Aecasorg/Equine-Foaling-Alarm/docs/UPGRADE-PLAN.md

# Upgrade programme — July 2026

The 2020 build triggers on a tilt switch alone, which can only answer *"is the mare
flat right now?"*. Mares also lie flat in normal REM sleep, so a tilt-only alarm is
structurally stuck between too sensitive (fires on naps) and not sensitive enough
(raise the threshold and miss the real thing). The sleeping position and the labour
position are the same position — the fix is to detect **behaviour** (motion patterns)
rather than **position**.

Three updates are planned. Code for 1 + 2 is already merged into
[`GiiFoalAlarm.ino`](../GiiFoalAlarm.ino); hardware is fitted step by step, sensor first.

## Status at a glance

| # | Update | Code | Hardware | Calibrated | Field-tested |
|---|---|:----:|:---:|:---:|:---:|
| 1 | MPU-6050 motion sensor | ✅ | ✅ 28 Jul 2026 | — self-arms | ☐ |
| 2 | Battery monitoring + heartbeat SMS | ✅ | ✅ 28 Jul 2026 | ✅ 30 Jul 2026 | ☐ |
| 3 | External charging socket | ✅ | ✅ 28 Jul 2026 | — | ☐ |
| 4 | Native UK SIM (roaming sunset) | — (no code) | ✅ 30 Jul 2026 | — | ☐ |

Hardware fitted 28 Jul 2026: GY-521 soldered in (its four unused pins INT/AD0/XCL/XDA
are parked on strips shared with unused MKR digital pins — **treat those digital pins
as reserved in any future code**), SDA/SCL/power run by wire, old tilt switches
desoldered, battery divider wired to A1, external socket wired to the 5V pin, and a
fresh LiPo fitted. External 5 V confirmed to power the board + sensor. Next:
flash, DIVIDER_RATIO check, bench arming + alarm tests, ship.

Legacy tilt-switch firmware (deployed 2022–2026) is archived in
[`legacy/GiiFoalAlarm-tilt-2022.ino`](../legacy/GiiFoalAlarm-tilt-2022.ino).

---

## 1. MPU-6050 motion sensor (major update)

Replace the two parallel ball tilt switches with a GY-521 (MPU-6050) accelerometer +
gyroscope, and replace the single "flat for 30 s" trigger with pattern detection.

**Wiring** (see [wiring-mpu6050-battery.svg](wiring-mpu6050-battery.svg)):

| GY-521 pin | MKR GSM 1400 pin |
|---|---|
| VCC | VCC (**3.3 V pin — not 5V**) |
| GND | GND |
| SCL | D12 (SCL) |
| SDA | D11 (SDA) |
| XDA / XCL / AD0 / INT | not connected (AD0 floating = I²C address 0x68, which the library expects) |

**Space-saving tip:** only the first four pins in the GY-521's row (VCC, GND, SCL,
SDA) are needed — snap the header down to a 4-pin piece, solder just those, and
leave XDA/XCL/AD0/INT pads empty (AD0 unconnected = address 0x68, which the library
expects). Dab of hot glue under the unsupported end. On perma-proto board, holes in
a column strip are connected — so a soldered-in pin "touching" an MKR pin's strip is
wired to it. Unused GY pins sharing strips with unused MKR pins (~2–~5) is
tolerable, but keep AD0 off anything that can sit high, and keep everything off the
D1 strip while the old tilt switches + pull-up are fitted — that strip still swings
3.3 V/GND as the balls roll. Best: desolder the tilt switches and their pull-up
(code-dead since the rewrite) — it frees board space too.

**Alarm tiers** (each sends a distinct SMS):

| Tier | Condition | Meaning |
|---|---|---|
| LABOUR | flat AND gyro-active for 8 s | fast, confident alarm — a sleeping mare is flat but *still* |
| BACKSTOP | **disabled** (`CALM_FLAT_BACKSTOP = 0`) | was "flat 25 min even if calm → check mare"; removed 2 Aug 2026 because mares rest flat routinely and it alerted on normal sleep. Trade-off accepted: no alert for a silent labour or a cast mare lying still. Set the constant (e.g. 3600 s) to re-enable |
| EARLY WARNING | ≥3 lie-down episodes in 20 min (3 s debounce) | stage-1 restlessness starting |

**Mounting hardware:** spring belt clips
([eBay 334736377513](https://www.ebay.co.uk/itm/334736377513), ✅ bought) — the box
clips onto the headcollar and pops off one-handed for charging, replacing the old
duct-tape/trigger-clip arrangement. Fit notes: the box must go back in the **same
position and orientation every time** (the axis calibration assumes it — mark the
spot), and a small keeper strap/lanyard is a cheap backstop since spring clips can
work loose on a horse that rubs or rolls.

**Self-arming detection (no manual calibration, no mode switch):** the device is
shipped to a remote operator, so nothing may require a laptop. The sketch learns
its own "upright" reference every time it is fitted: at power-on, and again after
every unplug from the charger, it enters a *settling* state (alarms off). Once its
gravity direction has held steady for 2 minutes — what naturally happens when it's
clipped on and hanging — it locks the reference and texts **"Foal alarm ARMED"**.
"Lying flat" is then any tilt more than 60° away from that reference. If it hasn't
armed within 30 minutes it texts a nudge to check it's clipped on. Every charge
cycle therefore re-fits the reference automatically.

Prefer the **dangling** arrangement: a hanging box self-plumbs, so grazing, head
position and box spin never move it off its reference. A rigid flat-to-cheekpiece
belt-clip mount also works, but a grazing head-down pose comes within ~10–15° of
the 60° flat threshold, so the margin is slimmer.

**Operator rules to ship with the device:** fit it to a *standing* horse, and
switch it on (or unplug it from the charger) around fitting time rather than hours
before — it locks onto the first steady orientation it sees, so don't let that be
a shelf. Wait for the ARMED text before walking away. **When switching it off,
leave it off for ~30 seconds before switching on again** — the radio coasts on
stored charge for several seconds (watch the LEDs fade), and a quick off–on wakes
it in a wedged state that can't reconnect. Off until dark + a few seconds = clean
start.

**Bench tests before shipping** (Serial Monitor @ 9600 shows
`state / |a| / tilt / stable / motion` once a second; for quick tests drop
`ARM_SECS` to ~15, then restore):
- Hang the box still by its clip → "Foal alarm ARMED" SMS after the settle period.
- Armed + hanging still → no further SMS.
- Lay it flat + shake/rock ~8 s → LABOUR SMS.
- Lay it flat + hold still → silence (nap immunity; the backstop text is disabled).
- Flat ≥3 s / upright / repeat ×3 → EARLY WARNING SMS.
- Plug the charger in → "Charger connected", alarms dormant; unplug → re-arms after
  a fresh settle.
- Text "status" to the SIM from a phone NOT in the alert list → within ~1 min the
  status reply lands ONLY on that phone.

**Main tuning dials:** `MOTION_THRESHOLD` (30 °/s) and `ACTIVE_SECS_LABOUR` (8 s) —
raise if jumpy, lower if deaf. `FLAT_ANGLE_DEG` (60°) for flat-detection margin,
`ARM_SECS` (120 s) for how long settling takes.

## 2. Battery monitoring + daily heartbeat SMS

Battery state becomes visible remotely instead of via the power-LED window.

**Hardware:** two 100 kΩ resistors (1% metal film) as a divider —
battery + (JST side of the on/off switch) → 100 kΩ → **A1** → 100 kΩ → GND.
Same diagram as update 1. Drain ~20 µA, negligible.

**Firmware (already in the sketch):**

| SMS | When |
|-----|---|
| `Foal alarm online. Batt 87% (3.95V). Arming once fitted & settled` | every power-on (doubles as install check) |
| `Foal alarm ARMED. Batt 85%` | orientation held steady 2 min — reference locked, monitoring live |
| `Foal alarm NOT armed yet - check it is clipped on and hanging still` | one nudge if still unarmed 30 min after power-on/unplug |
| `Foal alarm OK (armed). Batt 78% (3.90V)` | daily heartbeat (~24 h) with armed state; a *missing* heartbeat means the unit is dead/flat/out of signal |
| `LOW BATTERY 3.38V - charge foal alarm` | sustained reading < 3.40 V; re-arms after charging past 3.70 V |
| `Charger connected. Batt 42%` | external 5 V detected — posture alarms suppressed while on charge |
| `Battery full - foal alarm ready` | charger present and the BQ24195 reports charge complete |
| `Foal alarm status: armed. Batt 78% (3.90V). Sig 12/31` | reply to any SMS starting with "status" (case-insensitive) — sent **only to the asking number**; inbox is polled every ~30 s, so allow up to a minute; all other inbound texts are discarded (keeps the modem's message store from filling) |

**Calibration:** compare the boot SMS voltage against a multimeter on the battery and
nudge `DIVIDER_RATIO` (2.0 nominal) until they agree. **Done 30 Jul 2026:** off-charger,
same-minute readings were SMS 4.02 V vs meter 4.03 V — 0.25% off, within resistor
tolerance, ratio kept at 2.0. (Note: "Battery full" tops out around ~89% on the SMS
scale by design — the charger terminates at ~4.11 V, not 4.20 V, for cell longevity.)

**Expected battery life:** ~2–4 days per charge (modem dominates; weak signal and
cold nights push it toward the low end). The heartbeat's day-over-day % drop gives
the true figure.

## 3. External charging socket (no more opening the box)

**Part:** 2-pin waterproof panel-mount USB-C female socket (e.g. RUNCCI-YUN,
Amazon B0CRD36F38 / B0CPLS1X29). Power-only — firmware flashing still uses the
internal USB port.

**Why it works without the USB connector** (see
[wiring-charge-port.svg](wiring-charge-port.svg)): on the MKR GSM 1400 schematic the
`5V` header pin is the same net as USB VBUS, behind polyfuse F1; that net feeds the
BQ24195L charger input through Schottky D3. Solder the socket's **+** to the `5V`
pin row and **−** to GND and charging is electrically identical to plugging in USB.
(`VIN` is *not* equivalent — it enters via a FET switch and does not run the charger.)

The board's LEDs (visible through the housing window) become the charge indicator:
green DL3 = charger present, orange DL2 = charging, orange off = full.

**Usage rules:**
1. Meter the socket's two wires for polarity before first connection — reversed
   polarity is unrecoverable.
2. Charge from a **USB-A charger with an A-to-C cable**. The 2-pin socket has no CC
   pull-down resistors, so C-to-C chargers deliver 0 V.
3. On/off switch **ON** while charging, otherwise the board runs but the battery
   can't fill.
4. Never feed the internal USB port and the external socket at the same time.

**Charge rate:** the charger's USB D+/D− detection lines are unpopulated on this
board, so input is capped at ~500 mA regardless of charger — a full 2500 mAh charge
from empty is ~5–6 h.

**Mounting:** ~12–14 mm hole in a *downward-facing* wall, gasket on a flat surface,
cap on in the field. The socket is a dead input while on the horse — no corrosion
or short risk.

**Charging routine** (with updates 1–3 all fitted): unclip the box from the
headcollar → plug into the dedicated USB-A charger in the tack room → clip back on.
The belt clip removes the tape faff, the socket removes the unscrew-the-lid step;
charging itself always happens off the horse.

**Firmware charger-awareness:** because the box is powered while charging (switch
must be ON) and lies flat on a shelf for hours, the sketch reads the BQ24195's
status register (read-only, shared I²C bus) each second. While external 5 V is
present the posture alarms are suppressed and their state zeroed — otherwise the
25-min backstop would text "CHECK MARE" during every charge. Plugging in sends
`Charger connected. Batt XX%` (proof the socket made contact), and charge
completion sends `Battery full - foal alarm ready`.

---

## 4. SIM replacement (diagnosed 29 Jul 2026)

The original Things Mobile (Italian roaming) SIM can no longer connect anywhere in
the UK on this hardware, through no fault of the device:

- The SARA-U201 modem is **2G/3G only**.
- All four UK operators completed their **3G switch-offs** by 2025.
- **O2 — the last UK network accepting inbound 2G roamers — withdrew that access
  from 1 Oct 2025** (Ofcom, "advice for IoT and third-party device suppliers").
  Foreign roaming SIMs on 2G-only devices now get rejected by every UK network.
- Confirmed by the AT diagnostic: modem healthy (IMEI OK), SIM healthy
  (`+CPIN: READY`), network heard and attach attempted, ends `+CREG: 0,3`
  = registration **denied** (policy, not signal).

**Fix:** a native UK PAYG SIM on the EE, O2 or Vodafone families (native/MVNO SIMs
are unaffected; their 2G runs until ~2029–2030).

**Decision: Lebara (Vodafone MVNO).** Already used for the farm's LTE surveillance
camera with good reception, so Vodafone has proven presence on site; Lebara SIMs
include Vodafone 2G access. Note the camera proves the 4G layer — verify the 2G
"calls & texts" layer for the farm postcode on Lebara's coverage checker before
relying on it. Lebara's ~90-day inactivity policy is covered by the daily
heartbeat SMS. Steps:

- [ ] Check **2G coverage at the farm** per network (signalchecker.co.uk) and pick
      accordingly — rural 900 MHz (O2/Vodafone) often carries further than
      1800 MHz (EE).
- [x] Fit SIM (slot on the underside of the MKR); Lebara ships PIN-free, so
      `SECRET_PINNUMBER` is now `""`.
- [x] Re-run the GSM diagnostic — **passed 30 Jul 2026**: registered on
      "Lebara" (2G, `+CREG: 0,1`). Bench signal CSQ 5/31 (weak indoors, as
      expected at that spot); status SMSes now report signal so the farm
      fitting gives the number that matters.
- [ ] Note: the daily heartbeat SMS doubles as the PAYG keep-alive — most PAYG
      SIMs deactivate after ~6 months without chargeable activity.

Long-term note: UK 2G sunsets ~2029–2030. If the alarm must outlive that, the
successor path is the pin-compatible Arduino MKR NB 1500 (LTE-M) — the MKRNB
library mirrors MKRGSM almost 1:1.

**Tool — reading SMS sent TO the alarm's SIM:** flash
[`tools/SmsInbox/SmsInbox.ino`](../tools/SmsInbox/SmsInbox.ino) (copy your
`arduino_secrets.h` into its folder) and open the Serial Monitor — every
incoming SMS is printed. Needed for one-time verification codes (Lebara app
registration), balance texts, etc. Re-flash the main sketch afterwards.

## Battery-only GSM attach failure (30 Jul 2026) — ROOT CAUSE FOUND, fix pending

Symptom: on battery only, no 4-blink (GSM `begin()` never succeeds), no SMS; plug
the charger in at the same spot and it registers and texts fine. Same location →
not signal: GSM attach draws ~2 A transmit bursts (max power at Sig 10–12), so
this was power delivery.

**Root cause (confirmed by test): the on/off switch's own contacts.** Jumpering
across the switch terminals — leaving all wires/crimps/connectors in circuit —
restored battery-only attach immediately. Aged, oxidised contacts (never
self-cleaning at ~50 mA idle) drop too much voltage during the 2 A bursts. The
switch ran the old battery for years on shrinking margin; the rebuild moved the
operating point just enough to expose it (hence the intermittent successes
earlier the same day).

**Update 31 Jul 2026 — battery shorted during the rebuild.** Red and black battery
leads got soldered to the same strip: dead short across the cell. Cell now rests at
2.87 V (below the 3.0 V over-discharge floor), "charges" suspiciously fast but won't
run the board — classic short-damaged cell (internal resistance up, capacity gone).
Board itself unharmed (runs on charger). **The cell is compromised and will be
replaced, not rehabilitated** — shorted + over-discharged LiPos are a charge-time
fire risk, unacceptable for an unattended stable device. Do not charge it
unattended; check for swelling/heat/smell and recycle it properly.

**Battery-path rebuild (one work package):**
- [x] Shorting joint removed; harness rebuilt.
- [x] Replacement pack fitted: 724957 (2.5 A listing), its JST direct into the
      MKR socket.
- [x] Inline fuse — **waived** (no holder fits the enclosure; the pack's PCM
      covers hard shorts; radial PTC polyfuse noted as zero-space retrofit).
- [x] 6 A SPST mini toggle spliced into the battery + line via soldered
      perfboard pads; old intermediate connector eliminated.
- [x] Re-verify battery-only attach — **passed 1 Aug 2026 with the case OPEN**
      (4 blinks + SMS on battery). Power path closed. Lid-on failure is a
      separate RF issue (next section).

## Lid-on attach failure — RESOLVED 2 Aug 2026

**Root cause: the thick red switch wires lay across the antenna coax / u.FL
zone; lid compression pressed them onto the feed line.** Rerouted to the far
side of the box → attaches with the lid on. Rule going forward: the coax and
u.FL keep an exclusion zone — no wiring crosses them — and the red pair gets
anchored (hot glue / adhesive tie) so vibration on the horse can't migrate it
back. Final proof: 3× battery-only boots with the lid screwed down + Sig
comparison lid-on vs lid-off (small delta = healthy baseline).

<details><summary>Original diagnosis notes (kept for reference)</summary>

## Lid-on attach failure (open, 1 Aug 2026) — RF path, not power

With the rebuild done, battery-only attach works case-open but fails with the
lid fitted → the lid only touches the RF path. The antenna is external; its coax
enters the box. Suspects in order:

1. Coax pinched at the lid seam (crushed coax ≈ disconnected antenna — look for
   a bite mark on the cable at the case joint).
2. Lid/foam pressure popping the u.FL off the board (open the box immediately
   after a lid-on failure and inspect before touching anything).
3. Foam crushing the coax flat against a board edge.
4. Plain signal margin at the known-weak bench spot (lid costs a couple of dB).

Tests (the boot SMS `Sig n/31` is the instrument):
- [ ] Lid resting vs screwed tight: attaches resting but not screwed =
      mechanical compression.
- [ ] Lid fully on, outdoors/at a window: attaches = box healthy, the shelf is a
      dead spot; the farm fitting (ARMED text signal) is the real verdict.
- [ ] Boot-SMS signal lid-off vs lid-on, same spot: small drop = lid innocent;
      collapse = the closure is wrecking the antenna path.

Fix if it's the seam pinch: a dedicated cable exit (notch or grommet + sealant)
placed so the lid never bears on the coax, with a slack loop inside so lid
pressure can't transfer to the u.FL.

**Findings 1 Aug (photos):** antenna identified — Molex "Cellular 6 Band" 105261
flex, adhered to the OUTSIDE of the long wall. Flex antennas need a
conductor-free zone behind the element, and the lid compresses the interior
stack (black foam block + battery pouch) against the inside of that exact wall.
The rerouted battery wires also now cross over the u.FL zone, giving lid
pressure a path onto the coax head. Refined tests:
- [ ] Meter the black foam (probes ~2 cm apart): any reading = conductive ESD
      foam = an RF absorber pressed on the antenna's back → replace with plain
      non-conductive foam.
- [ ] Lid on with the black foam removed → attaches = culprit confirmed.
- [ ] Open immediately after a lid-on failure: is the u.FL still seated flush?
- [ ] Ensure the battery pouch (metal slab) doesn't press flat against the
      antenna wall under compression; pad with non-conductive foam.
- [ ] Dress wires so nothing crosses the u.FL head; optional rigid bridge over
      it as armour.

</details>

## Before shipping — final checklist

- [ ] **Set the ship recipients in `arduino_secrets.h`**: `SECRET_PHONE_NUMBER`
      = mum (testing currently uses Henrik's number), `SECRET_PHONE_NUMBER_2`
      = Henrik, for remote monitoring ("" disables a slot). Re-flash and
      confirm the boot SMS arrives on both phones. Two recipients = double
      the SMS count on the Lebara tariff.
- [ ] Restore any thresholds relaxed for bench testing (`ARM_SECS` 120;
      `CALM_FLAT_BACKSTOP` stays 0 = backstop disabled by owner decision).
- [ ] Full bench pass: ARMED SMS, labour, backstop, restless, charger
      connect/full/re-arm.
- [ ] New ≥3 A power switch fitted; battery-only GSM attach re-verified
      (several boots + an alarm SMS on battery).
- [ ] Charge to 100 % (orange LED off, `Battery full` SMS).
- [ ] Pack the dedicated USB-A charger + A-to-C cable with the device, plus the
      one-page operator note (fit to a standing horse, wait for the ARMED text,
      charge daily, heartbeat = it's alive).

## Parts list (all three updates)

| Part | Spec | Qty | ~Cost |
|---|---|-----|---|
| MPU-6050 module | GY-521 breakout | 2 (one spare) | £2–3 ea |
| Resistors | 100 kΩ 1% metal film | 2 | pennies |
| USB-C panel socket | 2-pin waterproof, screw-in (RUNCCI-YUN) | pack | ~£8–10 |
| Hook-up wire | thin solid-core | — | ~£2 |
| On/off switch | ✅ bought: SPST mini toggle, 6 A/125 VAC, pre-wired 0.5 mm² leads, 6 mm bushing. Solder (never crimp) where its leads join the harness; add an M6 rubber toggle boot for weather sealing | 1 | ~£2–3 |
| LiPo battery | Existing pack is a 785060 (7.8×50×60). Two candidates, decided by **measured clearance above the battery bay** (a LiPo must never be compressed, and packs swell with age): **≥12 mm free height → 105151** (10×51×53, 3000 mAh, 1.5 A std / 3 A max — electrically the best); **tighter → 724957** (7.2×49×57–59, 2500 mAh; buy the listing that specs 1.25 A std / 2.5 A max — seller tables vary). 375678 rejected: 80 mm too long. **Meter the JST plug polarity before connecting — aftermarket packs often ship reversed and a swapped plug kills the board** | 1 | ~£10 |
| Inline fuse | **Waived** (no holder fits the enclosure; the pack's own PCM covers hard shorts). Zero-space retrofit option if ever wanted: radial PTC polyfuse, hold ≥3 A (RUEF300-class), soldered inline in the + lead under heat-shrink | — | — |
| On/off switch | ≥3 A rated, sealed/rubber boot preferred | 1 | ~£2–3 |
| Belt clips | spring clip, box-to-headcollar quick release ([eBay 334736377513](https://www.ebay.co.uk/itm/334736377513)) | — | ✅ bought |

## Next season (2027) improvements

Field experience 2026: the antenna coax / u.FL zone remains the device's weak
point under shipping + horse vibration ("interference" recurred at the farm).

**Field report, Aug 2026:** armed on the horse at the farm (Sig 14/31 — farm
coverage confirmed good), then went silent; found next day pulled off the
headcollar (herd mate suspected) after a night on the ground — **and found
switched OFF**: the pull-off likely flipped the toggle, so the overnight
silence's primary cause was power loss, with the lid-on coax issue as a second
fault to clear. Still worked lid-open in the garden (Sig 18/31) but not lid-on
→ the known coax/u.FL mechanical fault, re-triggered by the pull-off/impact
(wires were never anchored). Consequences: (a) the keeper strap through the
belt clip is now REQUIRED, not suggested; (b) the missing-heartbeat dead-man
signal worked — that's what prompted the check; (c) the switch needs
protection (see below).

- **Fall-off detection** (new, field-driven): re-purpose the disabled backstop
  tier — a fallen-off box reads as "flat + motionless for hours", which no
  napping mare sustains. Threshold 60–90 min, message
  "Device may have come off the horse - check it" (distinct from the old
  CHECK MARE text). One constant + one string.
- **Switch protection** (field-driven — the box was found switched off after
  the pull-off, and fall-off detection only works if the fall leaves the device
  powered): rubber boot (weather + stiffer action) plus a toggle guard or
  recessed bezel so nothing sweeping past can flip the lever; or relocate the
  switch to the horse-side face — unreachable to herd mates by geometry, still
  accessible at fitting (switching always happens off the horse; could share
  the drilling session with the SMA bulkhead). **Interim field measure: a flap
  of electrical tape over the switch after fitting.**

- **Antenna robustness package** (the structural fix): u.FL→SMA bulkhead pigtail
  through the box wall + rigid external stub antenna. Seat the u.FL once and
  glue-stake it; bulkhead is strain-relieved and sealed. Interim measures that
  should happen at the next box-opening regardless: anchor the red DC pair to
  the far wall, glue-stake the u.FL + coax, twist the DC pair (kills its loop
  area). NOT foil wrap — coax is already shielded; floating foil near the
  element/feed detunes it further.
- **`status` reply gains tilt telemetry**: when armed, append the live angle
  from reference, e.g. `Tilt 12deg (flat >60)`; while arming, append settling
  progress, e.g. `settling 45/120s`. Makes remote diagnosis of arming/flat
  detection possible.
- **Remote re-arm command**: text `rearm` → device disarms and starts a fresh
  settling cycle (same path as unplugging the charger), confirms with
  "Re-arming - will text ARMED when settled". Restrict this command to the two
  alert-list numbers (unlike `status`, it changes device state).

## Parked ideas (not scheduled)

- Charging-status SMS ("plugged in" / "battery full") via the `Arduino_PMIC` library.
- Rigid GoPro-style or Fidlock cradle — fallback if the belt clips (bought, see
  update 1 mounting) prove insecure or don't hold a repeatable orientation.
- Heartbeat at a fixed clock time (RTCZero + network time) instead of ~24 h rolling.
- MCU sleep + MPU motion-interrupt wake for multi-week battery life.
- Second complete unit as a hot spare / swap-to-charge.
- Vulva magnet + reed switch (vet-fitted, Foalert-style) as a near-certain stage-2
  trigger complementing the behavioural early warning.
