Aecasorg/Equine-Foaling-Alarm/(commit log)

2026-07-26 Add 2026 upgrade programme: MPU-6050 sensing, battery telemetry, charge port
    Three tracked updates (status + wiring diagrams in docs/UPGRADE-PLAN.md):
    1. MPU-6050 (GY-521) replaces the parallel tilt switches. Detects labour
    behaviour instead of position alone: flat+active labour alarm, 25 min
    long-flat backstop, restlessness early warning. Supports the current
    hanging clip mount (hang-axis slack detection) and a future fixed
    cheekpiece mount via HANGING_MOUNT.
    2. Battery telemetry: 2x100k divider on A1, boot/daily-heartbeat SMS with
    battery %, sustained low-battery warning.
    3. External waterproof USB-C charge socket wired to the 5V pin (same net
    as USB VBUS -> F1 -> D3 ->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
    [GiiFoalAlarm-tilt-2022.ino, GiiFoalAlarm.ino]
2026-07-26 Add belt-clip mounting to the upgrade plan
    Spring belt clips bought (eBay 334736377513) for one-handed box-on/box-off
    mounting to the headcollar. Documented the HANGING_MOUNT decision at fitting
    time (flat against the cheekpiece -> false, dangling -> true), repeatable-
    position + keeper-strap notes, and demoted the cradle idea to a fallback.
2026-07-26 Clarify charging routine: always off the horse
    Unclip -> charge in the tack room -> clip back on. The belt clip and the
    external socket each remove a step of faff; neither enables on-horse charging.
2026-07-26 Add GY-521 soldering guidance for the cramped perfboard
    Solder only the 4 contiguous used pins (VCC/GND/SCL/SDA); AD0 must never
    sit high (address flips to 0x69), and the D1 strip stays live via the old
    tilt switches + pull-up until they are desoldered.
2026-07-28 Mark updates 1-3 hardware fitted; make LED blinks reliable on cold boot
    pinMode(LED_BUILTIN, OUTPUT) was never called (since 2020) - the LED only
    worked when the bootloader happened to leave the pin configured. Matters now
    that the LEDs are the through-window charge indicator.
    Status: GY-521 in (unused pins parked on unused MKR strips - those digital
    pins are now reserved), tilt switches removed, divider on A1, external socket
    on the 5V pin, fresh LiPo. External 5V confirmed powering board + sensor.
2026-07-28 Suppress posture alarms while on the charger
    The external socket means the box now runs while charging - lying flat on
    a shelf for 5-6 h, which would fire the 25-min CHECK MARE backstop every
    charge (and a full alarm if the box gets knocked). The sketch now reads the
    BQ24195 system-status register each second (read-only, shared I2C bus):
    while external 5V is present the posture alarm state is held at zero, and
    the unit texts "Charger connected" on plug-in and "Battery full" at
    charge termination.
2026-07-28 Replace manual calibration with self-arming orientation learning
    The device ships to a remote operator, so nothing may require Serial or a
    laptop. Instead of a hand-picked axis + HANGING_MOUNT switch, the sketch now
    captures the full gravity vector: on power-on (and after every charger
    unplug) it settles, locks a reference once the orientation has held steady
    for 2 minutes, and texts ARMED. Flat = tilting >60 degrees from that
    reference - works for the dangling mount (self-plumbing, preferred) and
    degrades gracefully on a rigid mount. Adds a 30-min "not armed yet" nudge
    and an armed/not-armed flag in the daily heartbeat.
    [GiiFoalAlarm.ino]
2026-07-28 Add pre-ship checklist (incl. restoring the real alert number)
    Testing runs with Henrik's own number in arduino_secrets.h - the checklist
    makes swapping back before shipping un-forgettable, plus threshold restore,
    full bench pass, 100% charge, and what to pack.
2026-07-28 Make GSM connect retries visible (LED flash + serial line per attempt)
    The connect loop was silent while failing, indistinguishable from a dead
    board - discovered while diagnosing a no-connect after the hardware refit.
    [GiiFoalAlarm.ino]
2026-07-29 Add update 4: replace roaming SIM (UK 2G inbound-roaming sunset)
    Diagnostic verdict: modem + SIM healthy, antenna fixed, but +CREG: 0,3 -
    registration denied by policy. UK 3G is fully off and O2 (last network
    accepting inbound 2G roamers) withdrew access from 1 Oct 2025, so the
    Things Mobile roaming SIM can never register on this 2G/3G modem. Fix is
    a native UK PAYG SIM (EE/O2/Vodafone family); farm coverage check first.
2026-07-29 Record SIM decision: Lebara (Vodafone MVNO)
    Vodafone presence at the farm is proven by the existing LTE camera; Lebara
    includes Vodafone 2G. Remaining check: the 2G calls-and-texts layer at the
    farm postcode (camera only proves 4G). Heartbeat SMS covers the 90-day
    inactivity rule.
2026-07-30 Add tools/SmsInbox: read SMS sent to the alarm's SIM over Serial
    Needed for one-time verification codes (e.g. registering the Lebara SIM
    in the Lebara app) without moving the SIM to a phone. Prints sender +
    body for every incoming SMS, then deletes it from modem storage.
2026-07-30 Detect charging with the switch off (battery out of circuit)
    The divider taps the JST side of the on/off switch, so ~0V on A1 while the
    board runs means the battery is switched out - not a flat cell. Charger
    connect now texts "no battery detected (switch OFF?) - NOT charging"
    instead of a misleading LOW BATTERY 0.03V, and the low-battery warning and
    "battery full" are suppressed in that state. Found during bench testing on
    USB with the switch off.
2026-07-30 Battery divider calibration verified: SMS 4.02V vs meter 4.03V
    Same-minute off-charger comparison; 0.25% agreement is within resistor
    tolerance, DIVIDER_RATIO stays 2.0. Also documented why "full" reads ~89%
    (BQ24195 terminates at ~4.11V by design).
2026-07-30 Log ship-blocker: GSM attach fails on battery, works on charger
    Same-location symptom rules out RF; GSM attach TX bursts (~2A at low
    signal) point at power delivery. Old battery ran years through the same
    switch; suspects are the new cell's protection PCB tripping or a disturbed
    crimp/switch contact. Test ladder documented (LED read, contact re-seat,
    switch bypass, cell-tab droop measurement).
2026-07-30 Battery-attach root cause confirmed: worn on/off switch contacts
    Jumper across the switch terminals (all wiring/crimps still in circuit)
    restored battery-only GSM attach immediately. Oxidised contacts drop too
    much voltage during 2A attach bursts. Fix: >=3A sealed switch, soldered
    lugs; added to parts list and pre-ship checklist. Bench testing continues
    jumpered.
2026-07-30 Support two SMS recipients
    sendSMS() now iterates a recipient list (sequential sends, seconds apart);
    an empty slot is skipped. SECRET_PHONE_NUMBER_2 added to the secrets
    template. Ship config: mum primary, Henrik second for remote monitoring.
    [GiiFoalAlarm.ino]
2026-08-01 Log battery short: cell compromised, replace as part of battery-path rebuild
    Red+black soldered to the same strip = dead short; cell rests at 2.87V,
    fast-full/no-runtime signature of short damage. Replacing (not recharging)
    - shorted + over-discharged LiPo is a charge-time fire risk for an
    unattended stable device. Rebuild package: new >=3A-protected cell, inline
    ~3A fuse in the + lead, >=3A switch, harness inspection, battery-only
    re-verification. Parts list updated.
2026-08-01 Relax battery spec to >=1C discharge; add JST polarity warning
    2.5A-max protected packs are fine - GSM TX bursts are sub-ms pulses that
    bulk caps + protection trip delays absorb. The real hazard with aftermarket
    pouches is reversed JST polarity, which kills the board on connection.
2026-08-01 Battery spec: 0.5C packs workable, 1C preferred; check pack thickness
    Candidate 724957 (2500mAh, PCM, JST-PHR-02, max 1.25A) is acceptable -
    sustained TX averages ~0.5A and bursts are sub-ms pulses. Fit note added:
    the chunkier packs differ in thickness, not just footprint.
2026-08-01 Battery decision: 724957 replaces the 785060 (375678 too long)
    Existing pack is a 785060 (7.8x50x60); the 724957 candidate is smaller on
    every axis so it drops into the same bay. Polarity check reminder stands.
2026-08-01 Battery choice becomes a clearance measurement: 105151 vs 724957
    105151 (10mm thick, 3000mAh, 3A max) is electrically best but 2.2mm
    thicker than the incumbent 785060; LiPos must not be compressed and swell
    with age, so >=12mm measured free height gates it. Otherwise the 724957.
2026-08-02 Record switch purchase: 6A SPST mini toggle, pre-wired leads
    Well over the 3A bar; solder-only joins into the harness, M6 rubber boot
    suggested for weather sealing.
2026-08-02 Waive the inline fuse: no holder fits; pack PCM covers hard shorts
    Radial PTC polyfuse (hold >=3A) noted as the zero-space retrofit if ever
    wanted.
2026-08-03 Power path closed (battery attach passed case-open); open lid-on RF issue
    Rebuild complete: new pack + 6A toggle, soldered path, fuse waived. Attach
    now works on battery with the case open - the remaining failure only
    appears with the lid fitted, which can only touch the RF path. Suspects:
    coax pinched at the lid seam, u.FL popped by lid/foam pressure, foam
    crush, or bench signal margin. Sig-in-SMS comparison is the instrument.
2026-08-03 Lid-on RF issue: antenna is a Molex 105261 flex on the outside wall
    The lid compresses the interior stack (black foam + battery pouch) against
    the inside of the antenna-bearing wall; rerouted wires also cross the u.FL
    zone. Refined test list: meter the black foam for conductivity (ESD foam =
    RF absorber), lid-on-without-foam, u.FL inspection, battery clearance,
    wire dressing.
2026-08-04 Lid-on RF issue resolved: switch wires lay on the antenna coax
    Rerouted the thick red pair to the far side; coax/u.FL now keep an
    exclusion zone. Remaining hardening: anchor the wires, 3x lid-screwed
    battery-only boots, Sig lid-on/off baseline. Old diagnosis notes folded
    into a details block.
2026-08-04 Add SMS "status" query: reply to the asking number only
    Text "status" (case-insensitive) to the SIM -> status report (state,
    battery, signal) sent only to the sender, not the alert list. Inbox
    polled every 30 s to preserve modem power-save; all other inbound texts
    are discarded so the message store can't fill over a season. Added to
    the SMS table and bench test list.
2026-08-04 Fix status reply: build the report before beginSMS
    signalStr() sends AT+CSQ to the modem; calling it after beginSMS (modem in
    text-entry mode) typed the command into the SMS body and returned no
    reading ("AT+CSQ ... Sig ?/31" - caught in field testing). The report is
    now fully built before the send starts. Boot/heartbeat texts were already
    safe (strings built before sendSMS).
    [GiiFoalAlarm.ino]
2026-08-04 Operator rule: leave the switch off ~30s before switching back on
    Bulk caps + modem rails coast for several seconds after switch-off; a
    quick off-on wakes the modem half-brown and it can fail to reattach even
    through the retry loop. Cold-boot after full drain works every time.
    Also explains the earlier "standing up = no signal" scare (confounded by
    rapid power cycling during those tests).
2026-08-04 Add the one-page operator note to ship with the device
    Fitting ritual (standing horse, wait for ARMED), text meanings incl. the
    missing-heartbeat rule and the status query, charging routine (USB-A brick
    only, LED meanings, ~2-day cadence), and the rules of thumb (30s off-time,
    hang freely, ~90% = full).
2026-08-04 Operator note: charge from any USB-A brick via the supplied cable
    Device draws max 0.5A@5V so any USB-A charger works; the A-to-C cable
    physically enforces the right port type, so "only use this cable" is the
    whole rule. No brick shipped - mum's kitchen charger does the job.
2026-08-05 Operator note: the supplied cable is black
2026-08-08 Plan next-season improvements: antenna robustness, tilt in status, remote rearm
    Field 2026 verdict: the u.FL/coax zone is the recurring weak point. 2027
    package: SMA bulkhead + stub antenna (structural fix), plus interim
    glue-staking/anchoring/twisted-pair at next box-opening; foil wrap
    explicitly rejected (coax already shielded, floating foil detunes).
    Features: status reply gains tilt/settling telemetry; "rearm" command
    restricted to alert-list numbers.
2026-08-08 Field report: farm signal good (14-18/31); pull-off re-triggered coax fault
    Armed on-horse at Sig 14/31, went silent, found pulled off after a night on
    the ground; works lid-open (Sig 18/31), dead lid-on = the known u.FL/coax
    mechanical fault. Keeper strap promoted to required. New next-season item:
    fall-off detection by re-purposing the disabled backstop (flat+still 60-90
    min -> "device may have come off the horse").
2026-08-08 Field addendum: box found switched OFF; add switch protection to 2027 plan
    The pull-off likely flipped the toggle, making power loss the primary cause
    of the overnight silence. Switch protection is the prerequisite for
    fall-off detection (a fall that powers the device down can't be reported).
    Options: boot + toggle guard/recessed bezel, or relocate the switch to the
    horse-side face. Interim: tape flap over the switch after fitting.
